david-el21/david-el21/Layout/Layout.JPG

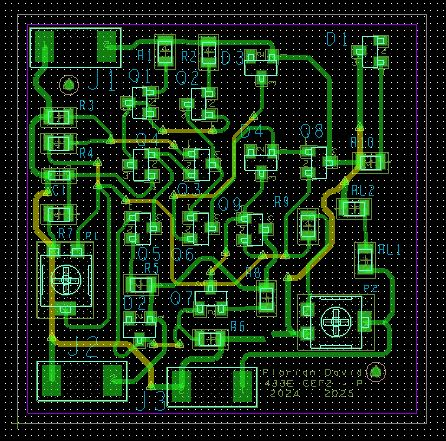
Layout/Layout.JPG
