david-el21/david-el21/Proiect docs/Oscilator semnal dreptunghiular-exemplu de proiectare.pdf

### GENERATOR DE IMPULSURI DREPTUNGHIULARE

### - exemplu de proiectare -

Presupunem ca se doreste obtinerea unui oscilator cu urmatoarele date de proiectare:

Frecventa de oscilatie reglabila in intervalul 2 5 KHz, factor de umplere 0.5; Sarcina la iesire 1 ;
Amplitudinea oscilatiei la iesire reglabila in intervalul 0.5 2.4V.

Conform datelor de proiectare circuitul va fi compus dintr-un oscilator de frecventa variabila, un amplificator de putere si un stabilizator.

1. Proiectarea oscilatorului

O posibila implementare pentru oscilator apare in fig.1.

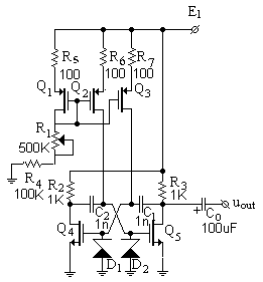
[picture p27: figure]

Fig. 1 Oscilator cu forma de unda la iesire dreptunghiulara.

Circuitul este unul basculant, astabil, comandat de oglinda de curent multipla Q1, Q2, Q3 . Se aleg Q1, Q2, Q3 de tip 2N6804 cu parametrii de catalog (VT=-3..-4V, Kp=10uA/V²
). Se
aleg Q4, Q5, de tip 2N6755 cu parametrii de catalog (VT=3..3.5V, Kn=20uA/V²
).

Semiperioada de oscilatie a acestui circuit este data de timpul de incarcare al unui

condensator C1,2 sub curentul de drena al Q1, Q2 la o tensiune aproximativ egala cu: E-Vz +VT.

Alegem diodele zener de tip PL5V6 (diode cu drift termic extrem de mic, pentru a avea o buna

independenta fata de temperatura, Izmin =10uA). Considerand E=7V, rezulta pentru frecventa

de 2KHz un curent de incarcare de circa 18uA, respectiv 22uA pentru 5KHz. Ecuatiile care

controleaza curentul de incarcare sunt:

E | V | R | R I 1 | SG1 | 1 | 4 | D1
(1)

2
D1 | D2 | D3 | p | SG | T I | I | I | K V | V
(2)

Rezistenta R4 are rolul de a limita curentul de drena al p- MOS-urilor atunci cand

cursorul lui R1 scurcircuiteaza aceasta rezistenta. Considerand o toleranta de 20% pentru aceste rezistente avem in cele mai defavorabile cazuri curenti de incarcare de 14uA respectiv

30uA, deci se poate acoperi gama de frecvente cerute.

Amplitudinea de oscilatie este data de valoarea lui E respectiv de tensiuna VDS atinsa de

tranzistoare in conductie. Amplitudinea maxima de oscilatie nu poate fi insa mai mare de 7V.

Pentru a aduce acest semnal in limitele impuse de datele de proiectare este necesara

introducerea unui etaj amplificator de putere precedat de un potentiometru de reglare a

amplitudinii. Eliminarea componentei continue a acestui semnal se face prin Co care se va

alege suficient de mare astfel incat sa nu apara un efect de filtru “ trece sus”. In particular, se

va folosi un condensator cu Ta de 100uF.

2.. Proiectarea amplificatorului

O implementare posibila (cu dispozitive discrete) a amplificatorului este prezentata in

Fig. 2.

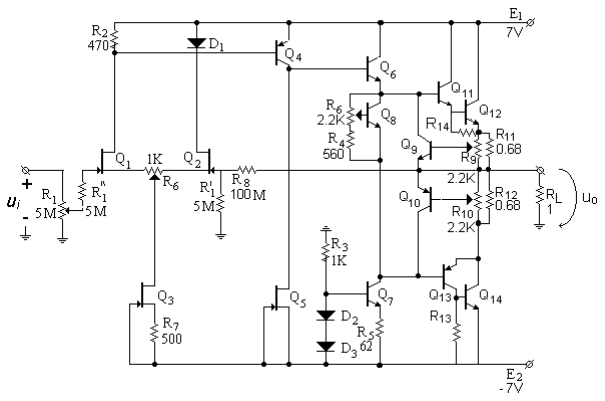
[picture p28: figure]

Fig. 2 Schema electrica a amplificatorului.

Acest circuit are o retea de reactie negativa Serie-Paralel, amplificare mare in bucla

deschisa, impedanta de intrare >5M , impedanta de iesire foarte mica.

Detalii de proiectare

Tranzistoarele din etajul diferential de intrare Q1,2 vor functiona in mod simetric la un

curent mai mic decat IDSS / 2 (Q1, Q2, Q3 se aleg de tip BF256 cu parametri de catalog

IDSS=6…10mA, VT = -1…-3V, VDSmax = 30V) pentru a putea permite maximum excursiei

asimetrice in curent intre tranzistoare. Suma curentilor de drena ai Q1,2 este:

I | I | I D1 | D2 | D3
(3)

Curentul ID3 este dat de ecuatiile:

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
D | DSS

GS

T

3 | 3

3

2
1
(5)

Presupunind pentru parametri IDSS, VT valorile tipice: IDSS = 8mA respectiv VT = -2V rezulta ID3 =

2mA. In cazurile cele mai defavorabile avem:

(IDSS=6mA, VT=-3V) | ID3 | 1.6mA
(IDSS=10mA, VT=-1V) | ID3 | 2.8mA

deci intotdeuna tranzistoarele de intrare Q1,2 vor functiona la un curent static de drena mai mic

decat IDSS /2.

Curentul prin Q1 este dat de relatia:

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
Alegem Q4 de tip BC 177 (pnp de mica putere) la care, conform curbelor de catalog,

VBE = 0.5…0.7V pentu IC = 10mA (la t = 25 C). Tinanad seama de toleranta lui R2 (5%) putem

determina:

ID1min=0.8mA; ID1max=1.2mA

Intotdeauna avem un curent diferit de 0 prin Q2.

Curentul prin Q4 | IDSS5 | (BF256, IDSS5= 6…10mA). Compensarea | functionarii

nesimetrice a Q1, Q2 se va face prin R1. Alegem R1=1K (20%) deoarece in cel mai defavorabil

caz (R1min, ID3min) se poate compensa o tensiune de 1.12V (mai mare decat diferenta (VGS1-

VGS2)max=0.8V.

Dioda D asigura functionarea Q1, Q2 la aproximativ aceeasi tensiune VDS. Curentul static

prin Q6, Q7 va fi ales suficient de mare astfel incat sa avem un stabil pentru tranzistoare iar

curentul de baza al tranzistoarelor finale sa fie neglijabiliar in raport cu acesta.

Ciruitul “superdioda” format din Q8, R6, R4 are rolul compensarii neliniaritatilor la

comutarea de pe untranzistor final pe celalalt, si al fixarii curentului de mers in gol pentru etajul

final. Tensiunea VCE8 este data de formula:

4 | 6
CE 8 | BE 8 | '
| | 6
R | R
V | V
R

(7)

Unde R’
6 este rezistenta din bratul lui R6 de langa R4, plus R4. Alegem Q8 de tipul BC107 (npn

de mica putere) la care, conform curbelor de catalog, VBE = 0.5…0.7V pentu IC = 10mA (la t =

25 C). Tinand sema de tolerantele componentelor VCE8 se poate regla in intervalul 0.5- 4.8. Q8

se va monta pe acelasi radiator cu tranzistoarele finale pentru ca superdioda sa copieze driftul

termic al acestora si curentul de mers in gol al etajului final sa nu se modifice.

Etajul final in clasa AB. Tranzitorul final NPN este un Darlington (Q11, Q12) si va suporta

in cel mai defavorabil caz 2.4A sau o tensiune CE de circa 14V. Alegem Q11 BC107 ( >100,

VCBO=25V, ICmax=100mA) si Q12 BD433 (Pmax=36W, VCBO=22V, ICmax=4A, 85< <150).

Tranzistorul echivalent are >8500 deci la curentul maxim Ib<0.2mA, deci neglijabil in raport cu

IC6. Tranzistoarele au ambele tensiuni de strapungere superioare celor ce pot aparea in montaj

deci problema strapungerii nu se pune. Curentul maxim suportat de Q11 este 28mA < ICmax.

Puterea disipata de tranzistorul echivalent este aproape in intregime localizata la nivelul Q12 si

in cel mai defavorabil caz este circa ½ din puterea in sarcina (5.6W) si in concluzie acest

tranzistor nu se poate distruge.

Tranzitorul final PNP este o configuratie Super G (Q13, Q14) si va suporta in cel mai

defavorabil caz 2.4A sau o tensiune VCE de circa 14V. Alegem Q13 de tip BC177 ( >100,

VCBO=25V, ICmax=100mA) si Q14 de tip BD434 (Pmax=36W, VCBO=22V, ICmax=4A, 85< <150).

Tranzistorul echivalent are >8500 deci la curentul maxim Ib<0.2mA, deci neglijabil in raport cu

IC6. Se vor face restul verificarilor identic ca pentru celalat tranzistor.

Rezistentele R13, R14 (1K) se aleg astfel incat sa forteze curent prin tranzistoarele de

mica putere si atunci cand curentul prin tranzistorul echivalent este mic (pentru a evita

scaderea lui odata cu cresterea sarcinii). In acelasi timp ele evita amplificarea curentilor

reziduali ai Q13, Q11 prin finalii de putere. Tinand seama de tolerantele tensiunii VBE si ale

rezistentelor R13, R14 (+/-20%) rezulta curentii minimi pentru perioadele de conductie de la care

se dechid finalii de putere si anume 0.5V/1.2K=0.4mA.

Circuitul de protectie pentru tranzistorul final NPN va limita curentul de baza al acestuia

la depasirea limitei de 2.5A. Pentru sistemul de protectie (cu limitare) ales este necesar ca in

caz de suprasarcina pe R11 sa cada o tensiune mai mare de 0.8V necesara deschiderii lui Q9

(uzual un NPN de mica putere). Alegem Q9 BC107 la care, conform curbelor de catalog,

VBEon = 0.5…0.7V. Pentru siguranta deschiderii lui Q9 alegem R11 = 0.68 (20%). La o

suprasarcina de 2.5A la bornele ei vor apare in cel mai defavorabil caz 1.3V. Aceasta tensiune

va fi preluata de divizorul rezistiv R9 care se va calibra in functie de parametrii concreti ai Q9. In

mod identic rezulta sistemul de protectie al PNP final.

Curentul de mers in gol al etajului se regleaza din tensiune VCE8, deoarece VCE8= VBE11+

VBE12+(R11+R12) Igol+VEB13. Acest curent (Igol) se alege la circa 1/20 din curentul maxim (in acest

caz aproximativ 0.12A). Rezulta ca avem nevoie in cel mai defavorabil caz (toate VBE sunt

maxime iar toleranta rezistentelor este +20%) de o tensiune de circa 4.8V, tensiune ce se

poate obtine din reglajul R6.

Amplificarea in bucla inchisa a etajului este data de formula A=(R1+R8)/R1. In

dimensionarea acestor rezistente se va tine seama ca R1 R

’
1 R8.

In final se va verifica prin calcul pe valorile nominale din schema functionarea in RAN a

tuturor componentelor active (la etajul final pot apare situatii de blocare (clasa B de

functionare)).

Se va studia circuitul in regim dinamic pentru functionarea pe una din alternantele

tensiunii de intrare (se va lua in calcul numi unul din finali, celalalt este blocat). Pe schema de

regim dinamic se vor determina av (obligatoriu >10.000), Av, RI
, R0. Valorile obtinute vor

satisface obligatoriu datele de proiectare.
