david-el21/david-el21/Simulations/Frecventa_maxima_Vvv_minim.PNG

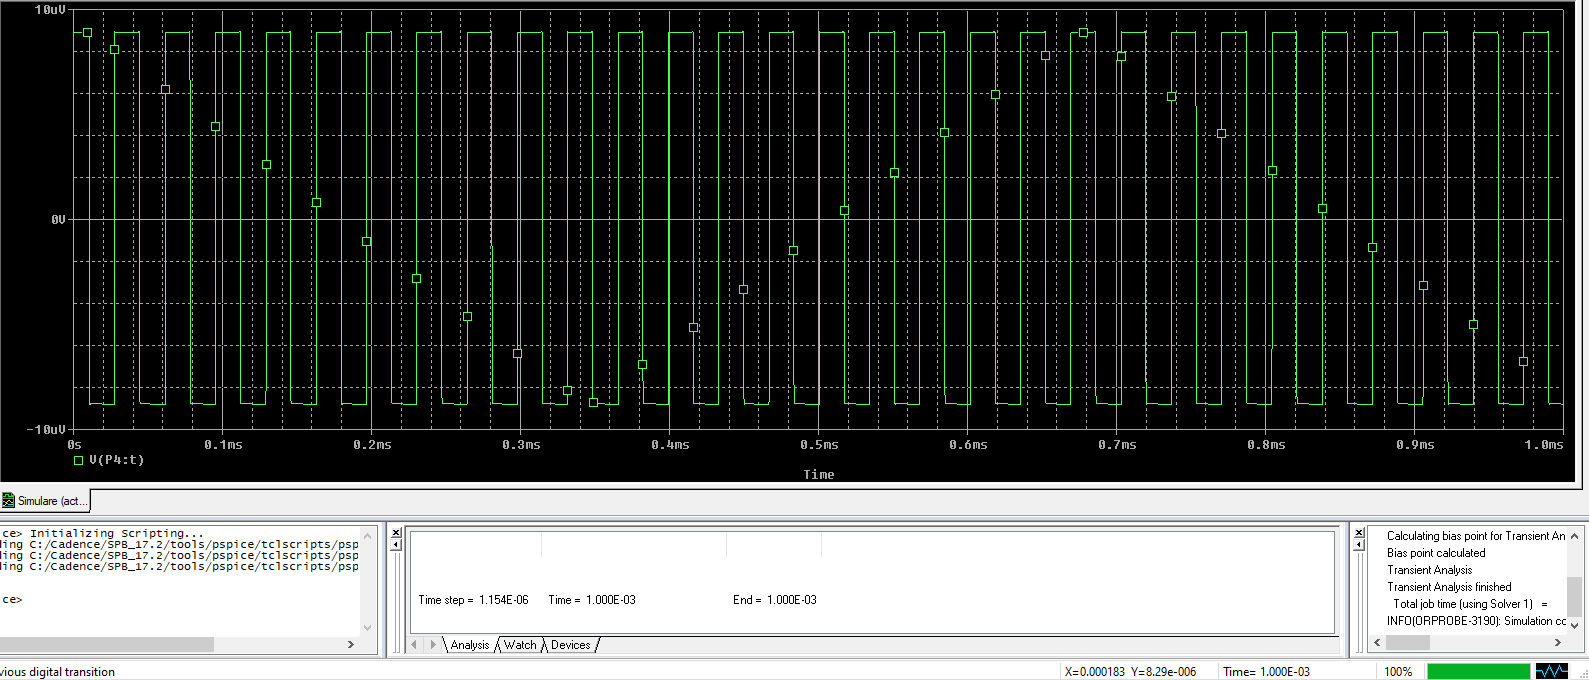
Simulations/Frecventa_maxima_Vvv_minim.PNG
