david-el21/david-el21/Simulations/PSF_CURENTI_AC.PNG

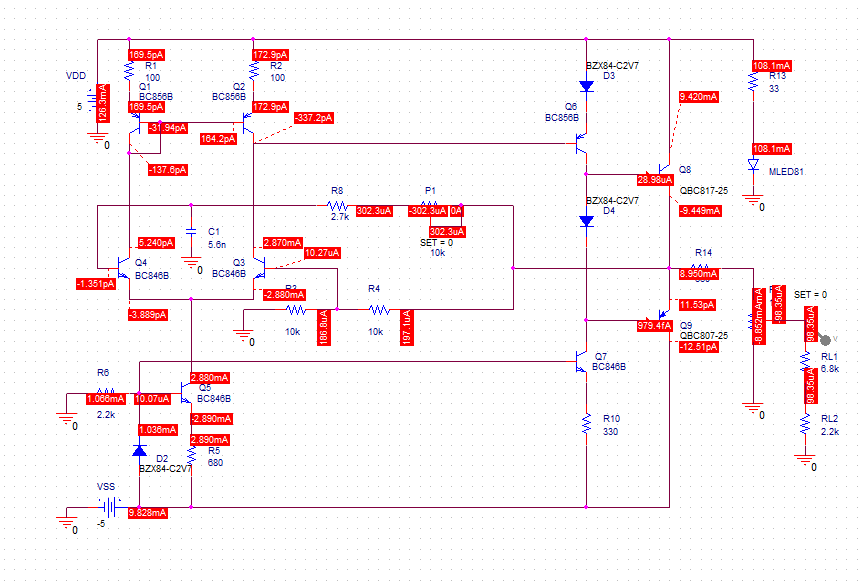
Simulations/PSF_CURENTI_AC.PNG
