david-el21/david-el21/Simulations/PSF_PUTERI_AC.PNG

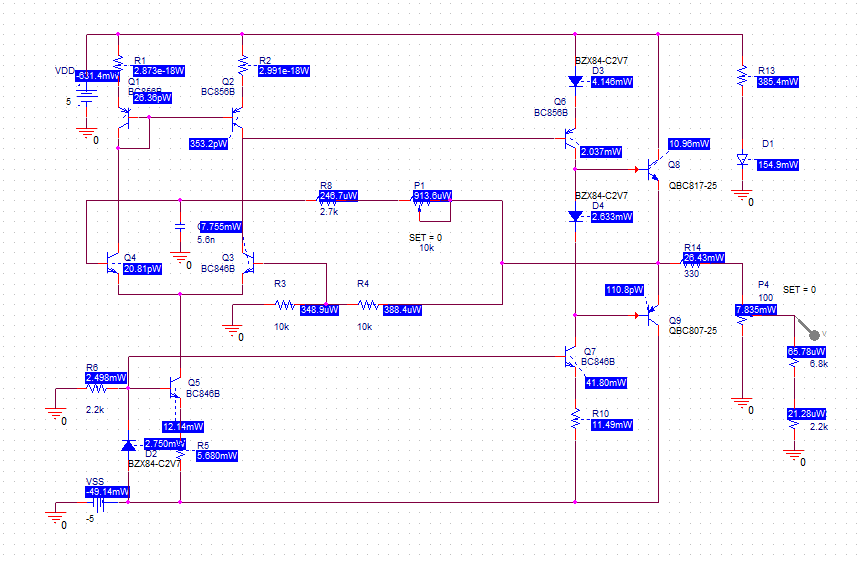
Simulations/PSF_PUTERI_AC.PNG
