david-el21/david-el21/Simulations/PSF_TENSIUNI.PNG

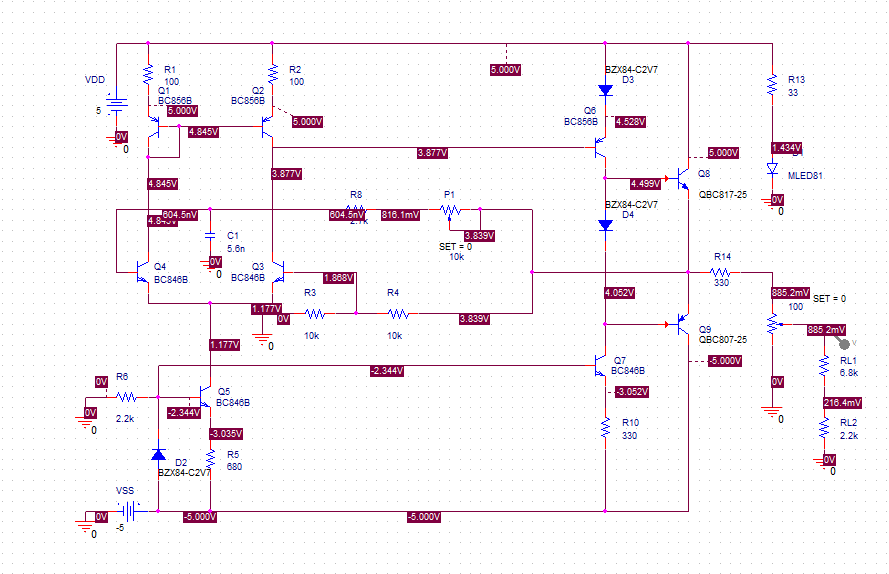
Simulations/PSF_TENSIUNI.PNG
