david-el21/david-el21/Bill of materials/BOM.JPG

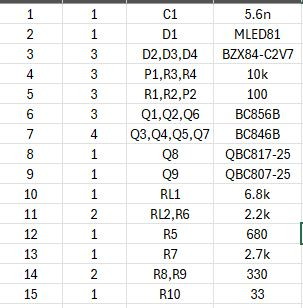
Bill of materials/BOM.JPG
