david-el21/david-el21/(list of files, drawings)

Other design files:
Schematics/Biblioteci componente/BC807-25.OLB
Schematics/Biblioteci componente/BC817-25.OLB
Schematics/Biblioteci componente/BC846B.OLB
Schematics/Biblioteci componente/BC856B.OLB
Schematics/Biblioteci componente/BZX84C2V7.OLB
Schematics/Biblioteci componente/BZX84C10.OLB
Schematics/Biblioteci componente/LED.olb
Schematics/GSD_FLORIAN_DAVID_433E.DSN
Schematics/GSD_Florian_David_433E.opj
Schematics/Schema_electrica_cu_conectori/Schema_cu_conectori.dsn
Schematics/Schema_electrica_cu_conectori/Schema_cu_conectori.opj
